blog-eivindgl-com/garage-door-extensions/(list of files, drawings)

Other design files:
Sketches/switch_and_display_module.fzz
