blog-eivindgl-com/garage-door-extensions/(threads)

Thread 1 (2025-05-03):

Create RFID reader

eloekset, 2025-05-03:
- An outdoor RFID reader with status LEDs and beeper
- Indoor magnet sensor to know when the door is closed
- ESP32 unit for logic and communication with an MQTT broker

eloekset, 2025-05-13:
Strategy to have the RFID reader working offline if WiFi drops: https://copilot.microsoft.com/shares/JXNuh1jpYbZPMRFPvkBcc

Closed 2025-07-31.

Thread 2 (2025-05-03):

Create open switch and display for counter

eloekset, 2025-05-03:
- Indoor ESP32 unit attached to control switches and display. Communicates with MQTT broker to receive messages from RFID and magnet sensor unit.
- A mosfet for 27V open switch of the original Windsor control unit
- An optocoupler for detection of emergency stop button of the original Windsor control unit. That button pulls a 28V signal high when the button is pressed/held. This is an important indicator, because we don’t want to trigger an alert if the garage door stays open when the emergency stop button is held.
- LED display for counter of door openings
- Buttons and LEDs to select type of counter for the display (day, week, month)

Closed 2025-08-02.

Thread 3 (2025-05-03):

Backend service with DB of valid RFIDs and counter of door openings

eloekset, 2025-05-03:
- Simple storage of valid RFID devices
- Simple storage of door opening timestamps
- Communicates with ESP32 modules over MQTT through a broker
- REST API for managing valid RFIDs

Closed 2025-07-25.

Thread 19 (2025-07-31):

Update sketches i Tinkercad

eloekset, 2025-07-31:
Sketches are drawn in this private Tinkercad file: https://www.tinkercad.com/things/alU4WmZrjrc-garage-door-extensions

The sketches must be updated with the latest changes, and the RFID module is not yet drawn.

eloekset, 2025-07-31:
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

RFID and door sensor module is complete on breadboards.

ESP32 WROOM 32D board is visualized as four 8-pin headers in the sketch.
 - D25 is used to send a signal to the display and switch module to open the door. This is the brown wire going out of the sketch into D33 of the other ESP WROOM 32D board.
 - D13 is the orange wire going to through a 100Ω resistor to the + input of the buzzer.
 - D26 is the green wire going through a 1kΩ resistor to the blue LED. This LED is blinking 1s on and 3s off to indicate the the RFID sensor is alive.
 - D27 is the green wire going through a 1kΩ resistor to the green LED. This LED turns on for 1s when a valid RFID card is presented to indicate that access to the door is granted.

RFID-RC522 module is visualized as an 8-pin header in the sketch.
  - SDA is the yellow wire connected to the ESP32 pin D5
  - SCK is the white wire connected to the ESP32 pin D18
  - MOSI is the green wire connected to the ESP32 pin D22
  - MISO is the blue wire connected to the ESP32 pin D19
  - IRQ is not connected
  - GND is the black wire connected to ESP32 GND pin through the breadboard
  - RST is the purple wire connected to ESP32 pin D21
  - 3V3 is the red wire connected to ESP32 3V3 output

Closed 2025-08-02.

Thread 23 (2025-08-02):

Pin to control Open Door switch must be changed

eloekset, 2025-08-02:
The Open Door switch should be wired close to the Emergency Stop pin because they are both going to be connected to optocouplers and require more physical space on the perf board.

A test has been done to verify that D25 can be used for interrupts and D33 can be used for output. So the display and switch module should be updated to switch functionality of those two pins.

Closed 2025-08-02.
