blog-eivindgl-com/garage-door-extensions/(commit log)

2025-07-17 Add API to get current door state
2025-07-30 Issue #2 - Create switch and display module
    [SevenSegmentDisplay.cpp, SevenSegmentDisplay.h, esp32_switch_and_display_module.ino]
2025-07-30 Issue #2 - Display module handles MQTT message to update display
    [esp32_switch_and_display_module.ino]
2025-07-30 Issue #1 - Open door on interrupt from RFID module
    [esp32_switch_and_display_module.ino]
2025-07-30 Issue #2 - Create door sensor module
    [esp32_rfid_and_door_sensor_module.ino]
2025-07-30 Issue #2 - Add discovery message for Home Assistant
    [esp32_rfid_and_door_sensor_module.ino]
2025-07-30 Issue #1 - Add RFID card reader and LEDs and buzzer
    [esp32_rfid_and_door_sensor_module.ino]
2025-07-30 Issue #1 - Use file with valid RFID values and validate cards before opening door
    [esp32_rfid_and_door_sensor_module.ino]
2025-07-30 Issue #10 - RFID module reports invalid RFID cards as MQTT message that the backend subscribes to and logs the RFID and a timestamp for when it was used.
    [esp32_rfid_and_door_sensor_module.ino]
2025-07-30 Issue #8 - RFID module updates its list of valid RFID cards
    [esp32_rfid_and_door_sensor_module.ino]
2025-07-31 Issue #19 - Update Tinkercad sketches for ESP32 modules
2025-07-31 Issue #19 - Update RFID and door sensor sketch and add a page describing the various components on the sketch
2025-07-31 Issue #19 - Update switch and display module sketch and add a page describing the various components on the sketch
2025-07-31 Issue #21 - Add support to display text and add a pushbutton to simulate the emergency stop button which can be held and released
    [SevenSegmentDisplay.cpp, SevenSegmentDisplay.h, esp32_switch_and_display_module.ino]
2025-08-01 Issue #21 - Emergency stop button through VO617A has been tested and working fine.
2025-08-01 Issue #21 - Control Open Door switch through a VO617A optocoupler. Left to be tested.
2025-08-01 Issue #21 - Optocoupler must be turned 180 degrees and no resistor between pin 4 and the +27V signal on the Open Door switch because the Windsor control unit needs all the current it expects to trigg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
2025-08-02 Issue #23 - Change pin 25 and 33 because of physical space on the perf board when soldering optocouplers
    [esp32_switch_and_display_module.ino]
2025-08-10 Issue #25 - Fix solder error and documentation
2026-02-02 Store some uncommitted work
    [switch_and_display_module.fzz]
